otvam/transformer_MF_MV_25kW/drawing/copper/termination_gnd.pdf

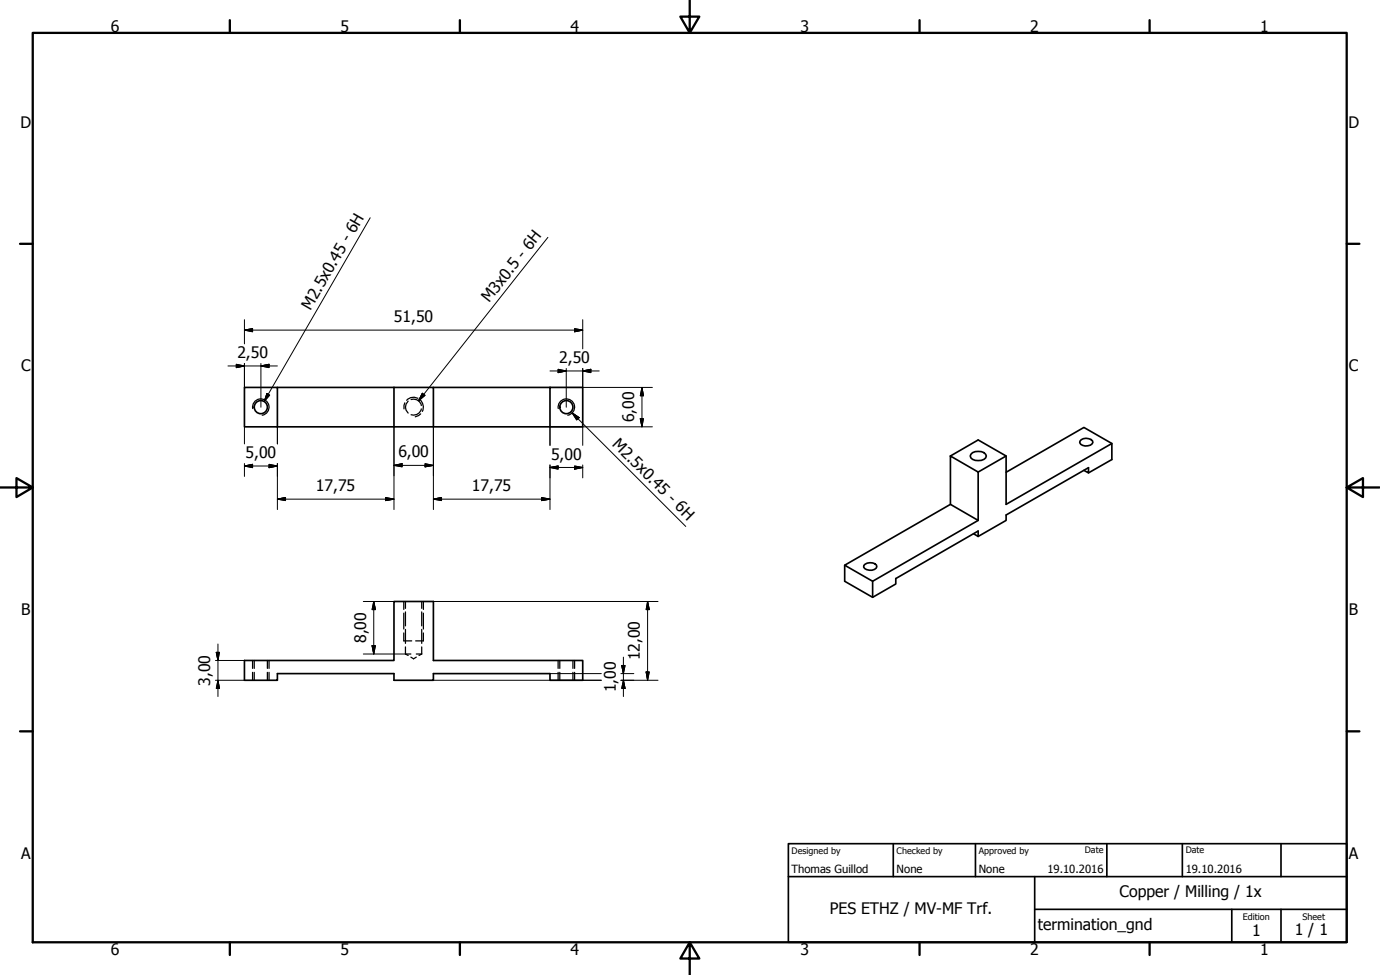
[picture p1: page 1]
Copper / Milling / 1x; termination_gnd; Thomas Guillod; None; Designed by; Checked by; Approved by; Date; Edition; Sheet

PES ETHZ / MV-MF Trf.
