otvam/transformer_MF_MV_25kW/drawing/copper/top_conductor.pdf

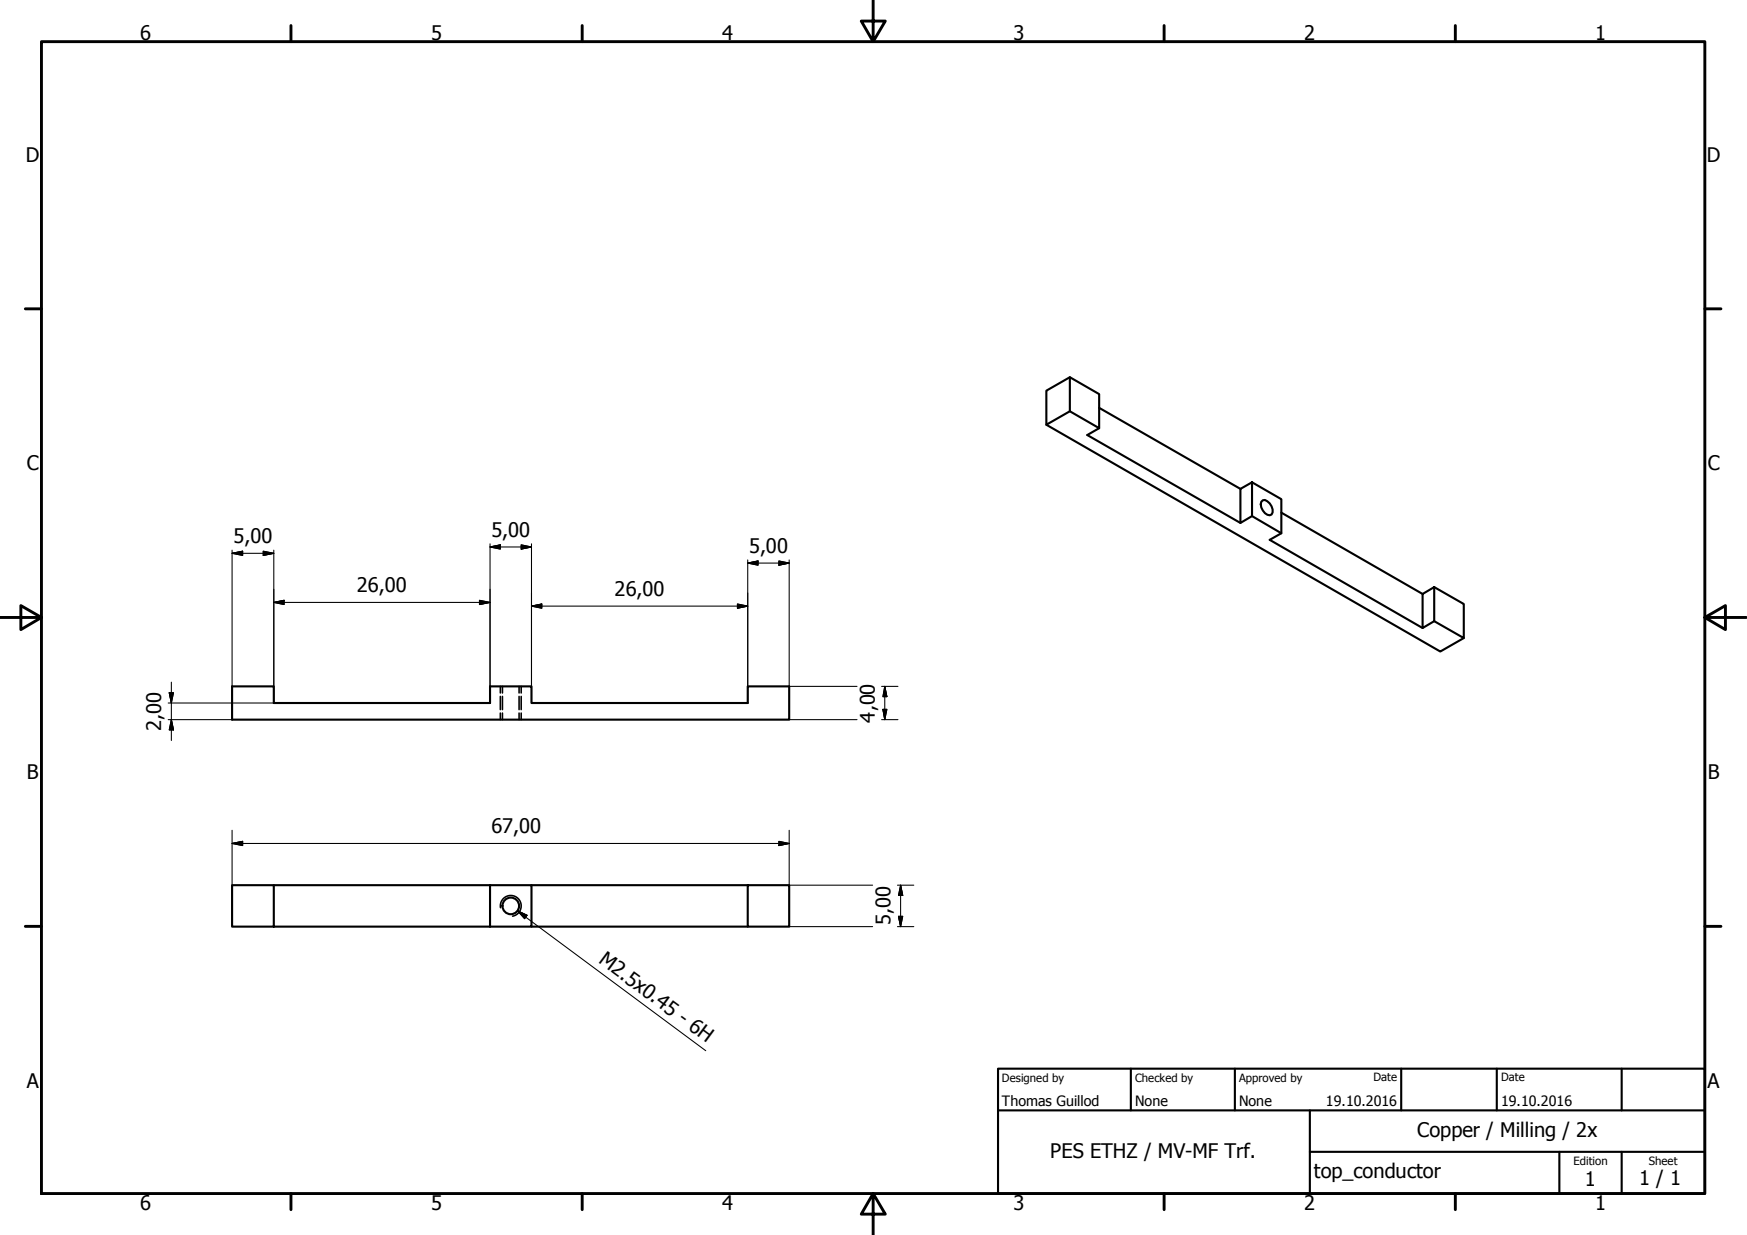
[picture p1: page 1]
Copper / Milling / 2x; top_conductor; Thomas Guillod; None; Designed by; Checked by; Approved by; Date; Edition; Sheet

PES ETHZ / MV-MF Trf.
