otvam/transformer_MF_MV_25kW/drawing/copper/termination_lv_conductor.pdf

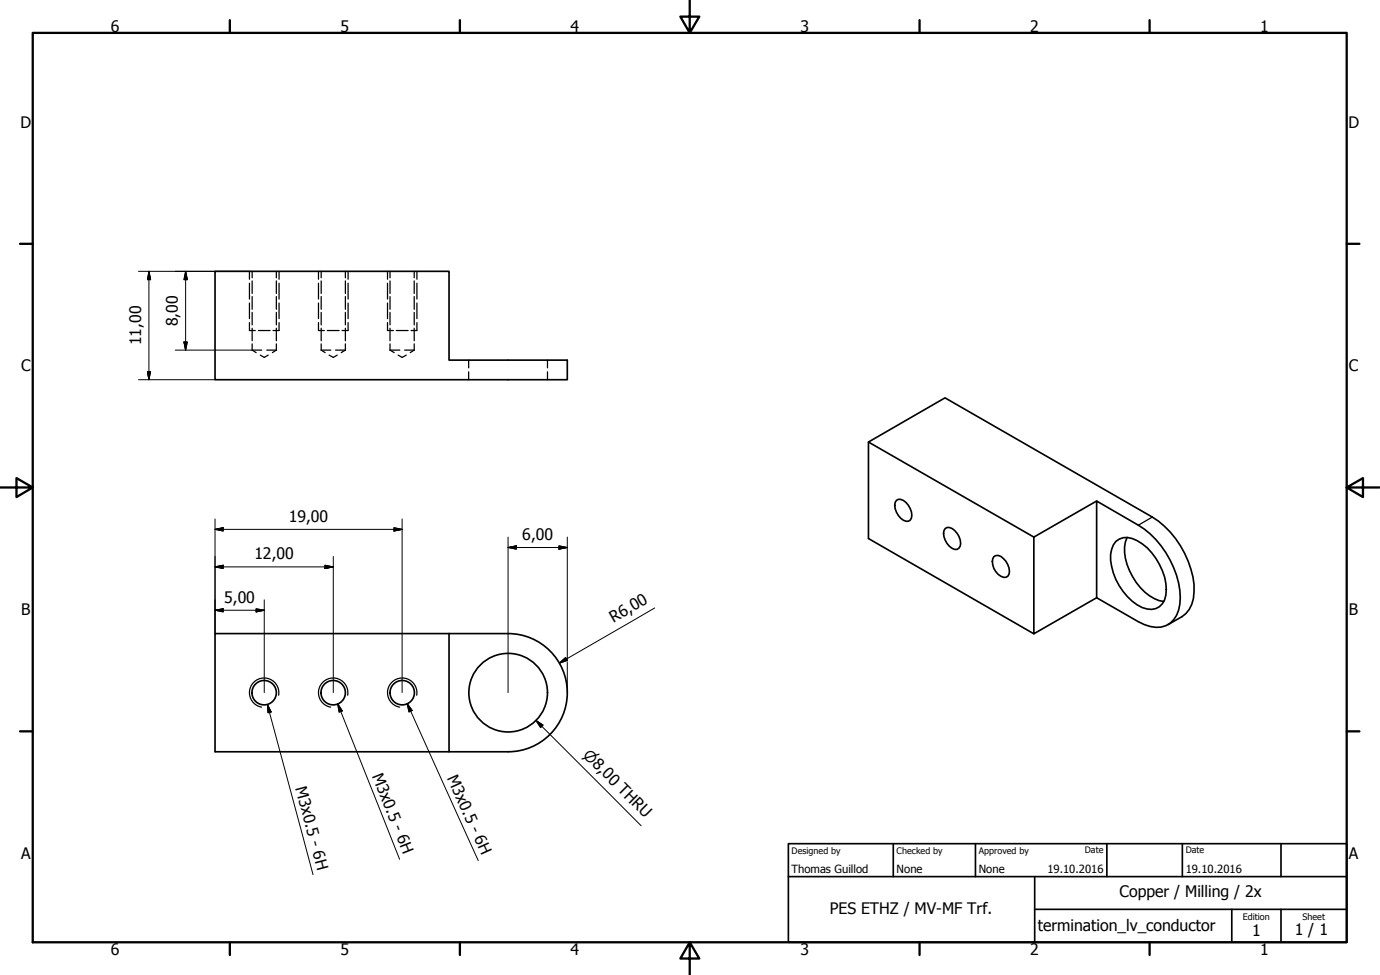
[picture p1: page 1]
Copper / Milling / 2x; termination_lv_conductor; Thomas Guillod; None; Designed by; Checked by; Approved by; Date; Edition; Sheet; P8,00 THRU

PES ETHZ / MV-MF Trf.
